mhellar/blasteroid-megasynth/hardware/cnc/PRINT_1to1_fit_test.pdf

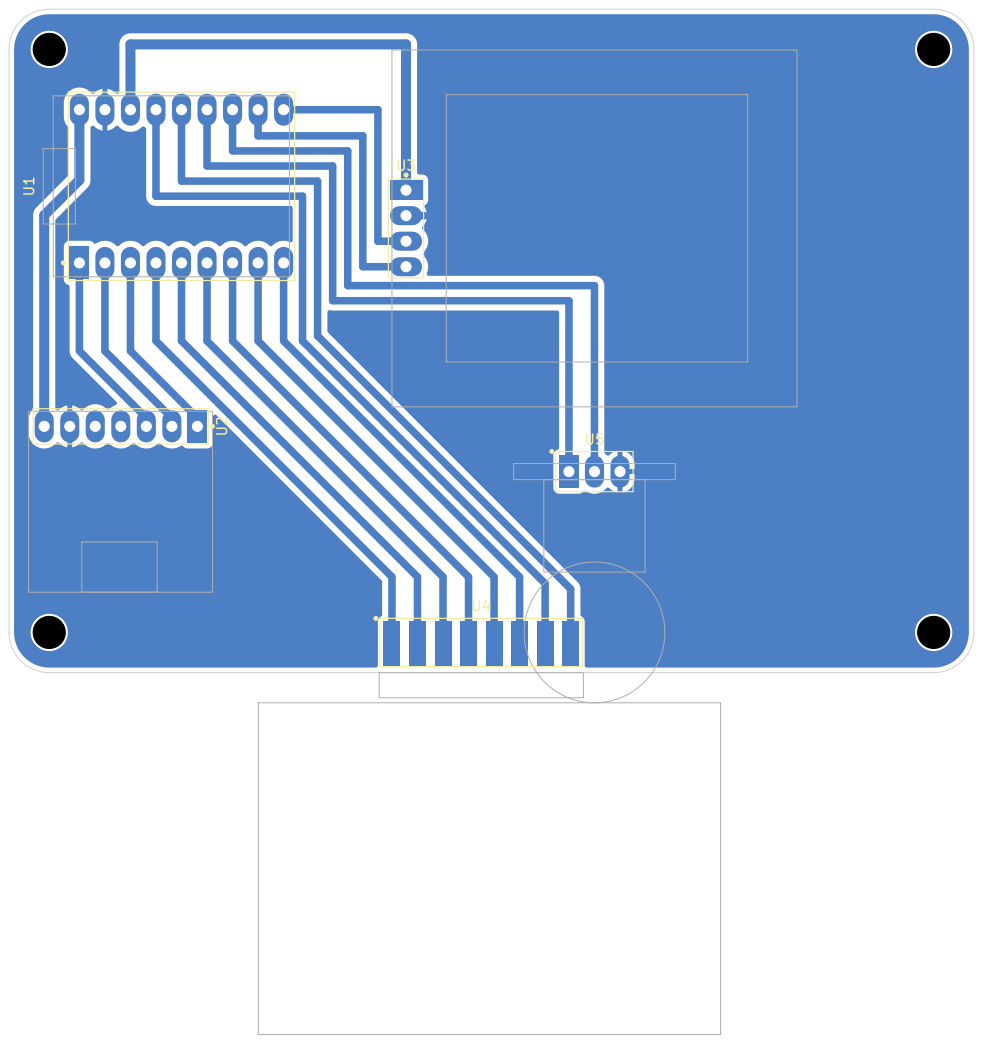
[picture p3: page 1]
