mhellar/blasteroid-megasynth/hardware/kicad/keypad_synth_revB.kicad_pcb

## KiCad design hardware/kicad/keypad_synth_revB.kicad_pcb (2026-10-04)

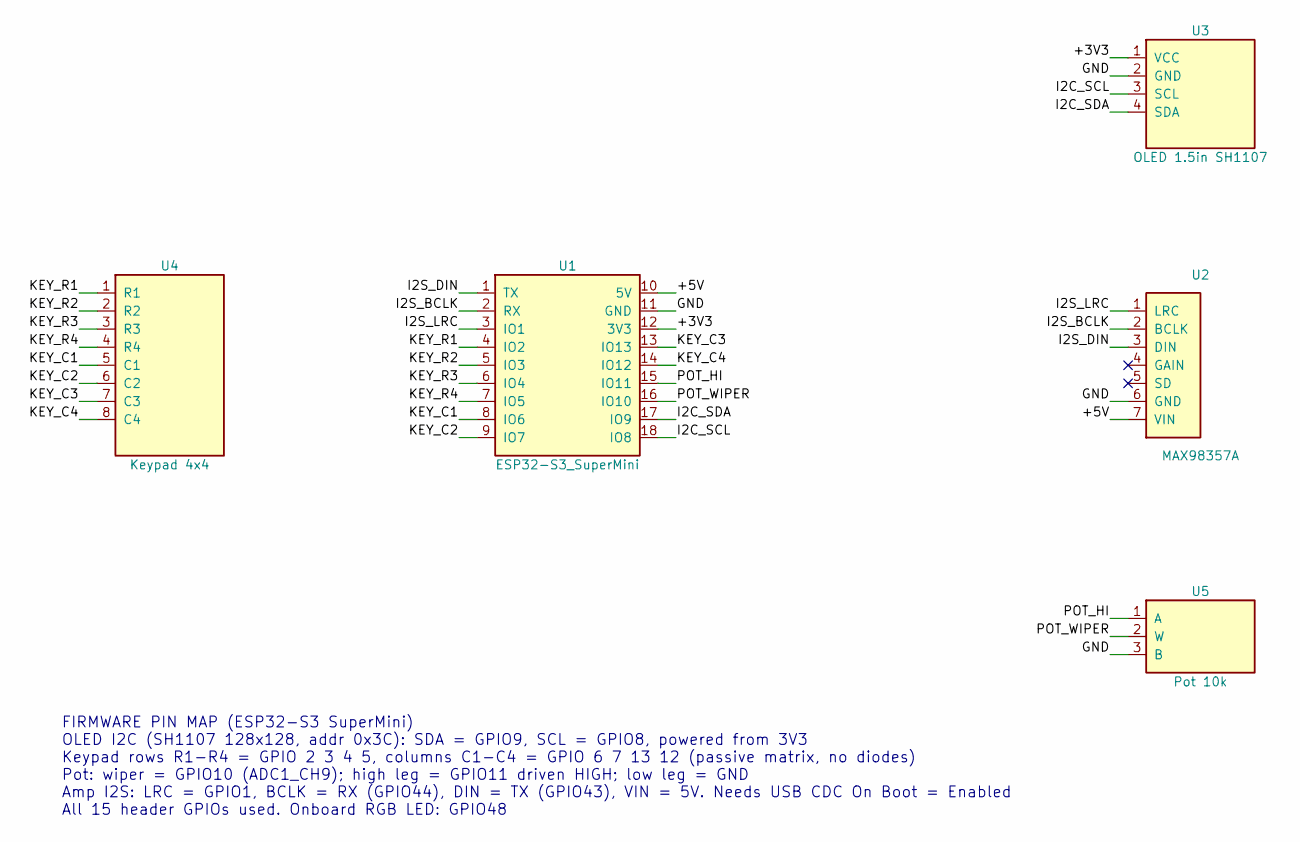
[picture p4: schematic keypad_synth_revB.kicad_sch, Keypad Synth Rev A]

Parts:
U1: ESP32-S3_SuperMini; ESP32-S3_SuperMini_CNC
U2: MAX98357A; MAX98357A_Module_CNC
U3: OLED 1.5in SH1107; OLED_1.5in_128x128_I2C_CNC
U4: Keypad 4x4; EdgePads_Keypad4x4_CNC
U5: Pot 10k; Pot_Standing_CNC

Connections:
/+3V3: U1.12 (3V3), U3.1 (VCC)
/+5V: U1.10 (5V), U2.7 (VIN)
/GND: U1.11 (GND), U2.6 (GND), U3.2 (GND), U5.3 (B)
/I2C_SCL: U1.18 (IO8), U3.3 (SCL)
/I2C_SDA: U1.17 (IO9), U3.4 (SDA)
/I2S_BCLK: U1.2 (RX), U2.2 (BCLK)
/I2S_DIN: U1.1 (TX), U2.3 (DIN)
/I2S_LRC: U1.3 (IO1), U2.1 (LRC)
/KEY_C1: U1.8 (IO6), U4.5 (C1)
/KEY_C2: U1.9 (IO7), U4.6 (C2)
/KEY_C3: U1.13 (IO13), U4.7 (C3)
/KEY_C4: U1.14 (IO12), U4.8 (C4)
/KEY_R1: U1.4 (IO2), U4.1 (R1)
/KEY_R2: U1.5 (IO3), U4.2 (R2)
/KEY_R3: U1.6 (IO4), U4.3 (R3)
/KEY_R4: U1.7 (IO5), U4.4 (R4)
/POT_HI: U1.15 (IO11), U5.1 (A)
/POT_WIPER: U1.16 (IO10), U5.2 (W)

Notes on the sheet:
FIRMWARE PIN MAP (ESP32-S3 SuperMini) OLED I2C (SH1107 128x128, addr 0x3C): SDA = GPIO9, SCL = GPIO8, powered from 3V3 Keypad rows R1-R4 = GPIO 2 3 4 5, columns C1-C4 = GPIO 6 7 13 12 (passive matrix, no diodes) Pot: wiper = GPIO10 (ADC1_CH9); high leg = GPIO11 driven HIGH; low leg = GND Amp I2S: L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

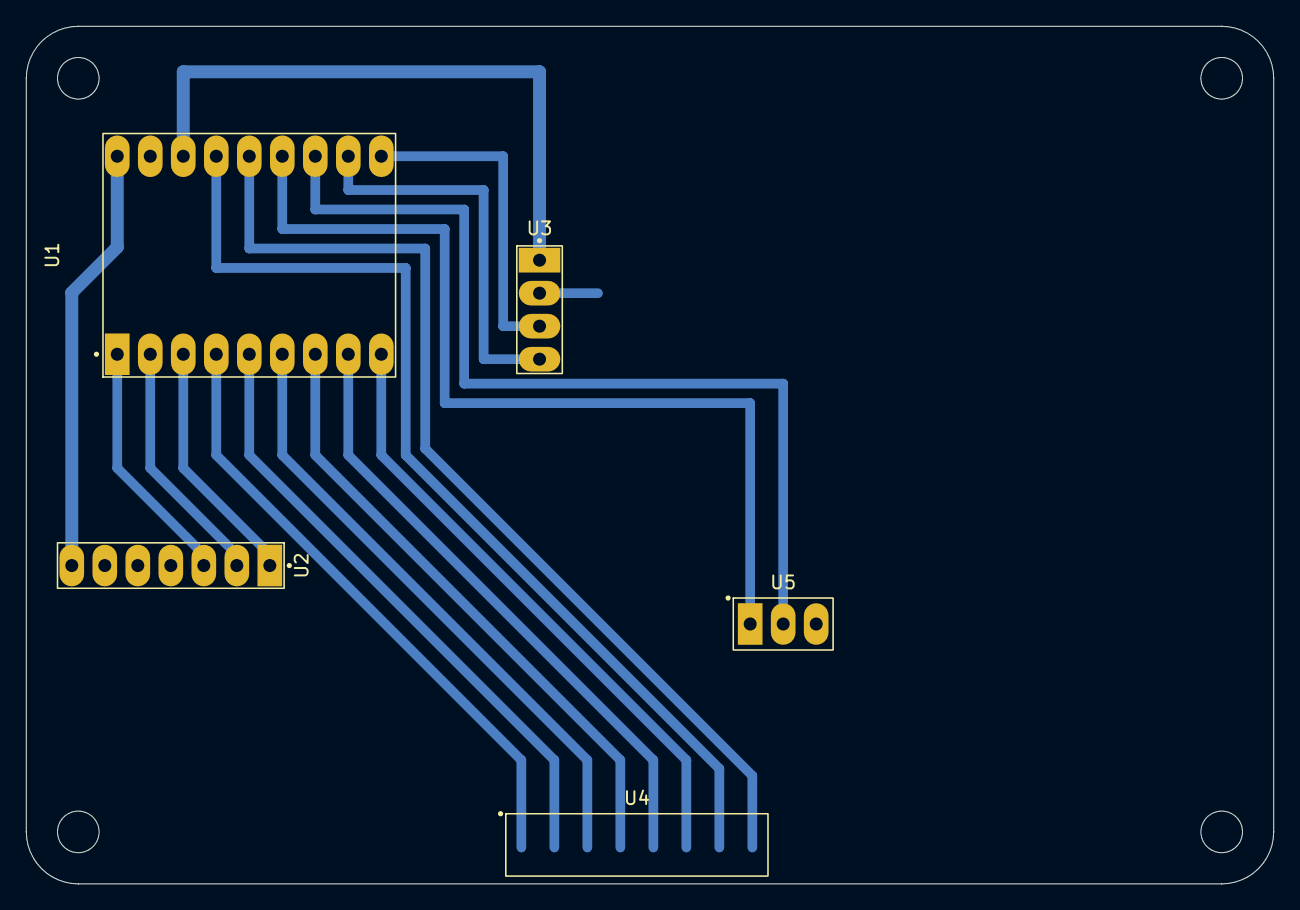
[picture p5: board keypad_synth_revB.kicad_pcb from above]

Board: 2 copper layers, 96.0 x 66.0 mm, 9 parts (0 on the bottom side), 18 nets.

Other parts of the board:
H1, H2, H3, H4: MountingHole_3.2mm_M3
