mhellar/blasteroid-megasynth/(commit log)

2026-10-04 OHM: industrial ambient firmware, keypad synth rev B board and CNC files
    Drone layers, SAM + Talkie voices (freeze, knob scratch, crosstalk),
    industrial machine kit, big FDN reverb on the knob, generative boot splash.
    Includes bring-up + short-finder sketches, KiCad project, Gerbers and G-code.
2026-10-04 Rename OHM to BLASTEROID MEGASYNTH, new cyclops laser logo
    The instrument is now Blasteroid Megasynth. The boot film ends with the
    particles converging into a cyborg cyclops in wraparound shades whose eye
    fires two lasers that burn the name in; SAM says it (rendered first, so it
    plays while the pad words are still loading), Talkie answers OPERATIONAL.
